Jetblack31/EcoPV/schematics/schematics.md

This directory contains schematics of EcoPV circuits.
