Jetblack31/EcoPV/devices/PCB_V1.png

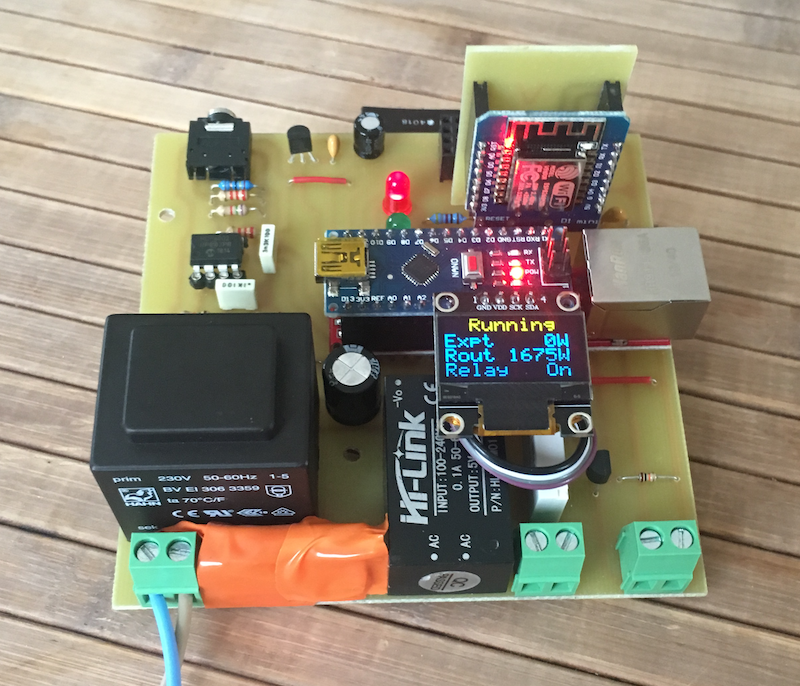
devices/PCB_V1.png
