Jetblack31/EcoPV/devices/ShieldEthernet.png

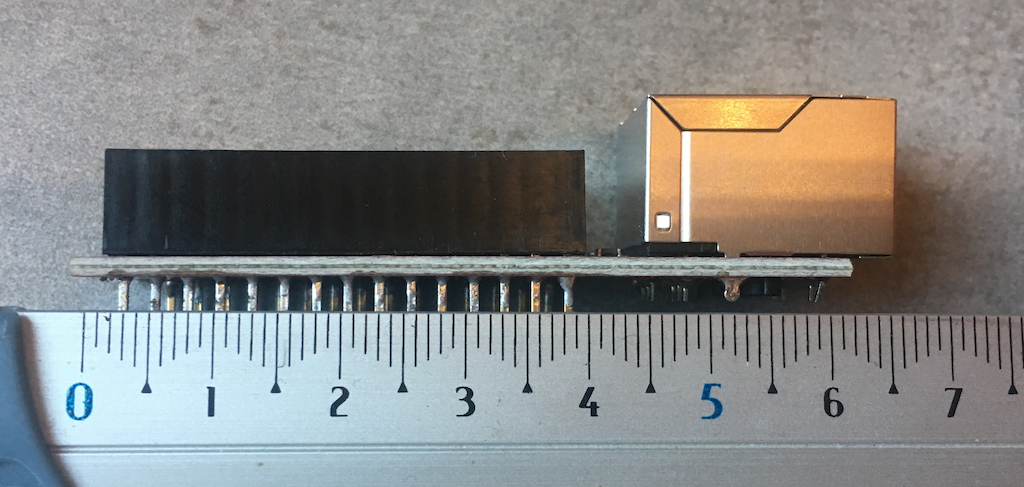
devices/ShieldEthernet.png
