Jetblack31/EcoPV/screenshots/MenuConfiguration.png

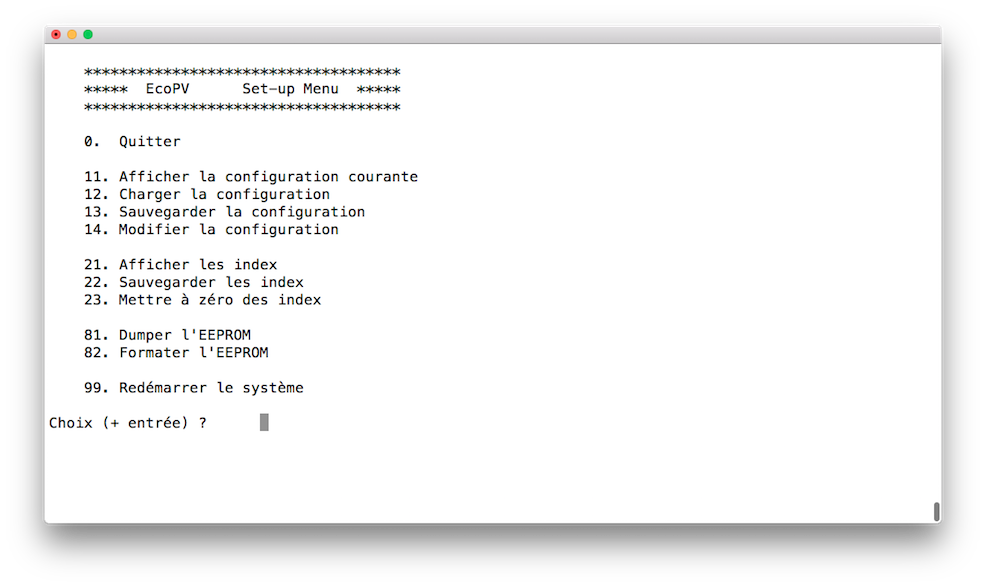
screenshots/MenuConfiguration.png
