Jetblack31/EcoPV/screenshots/openHAB.png

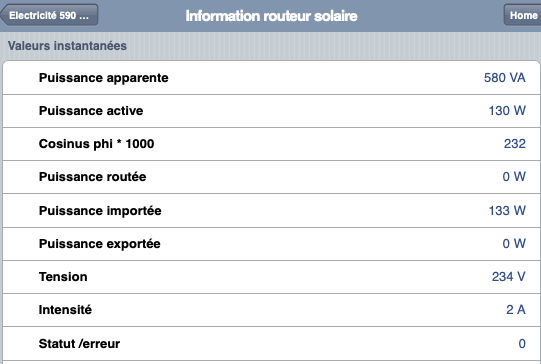
screenshots/openHAB.png
