Jetblack31/EcoPV/screenshots/Paramètres.png

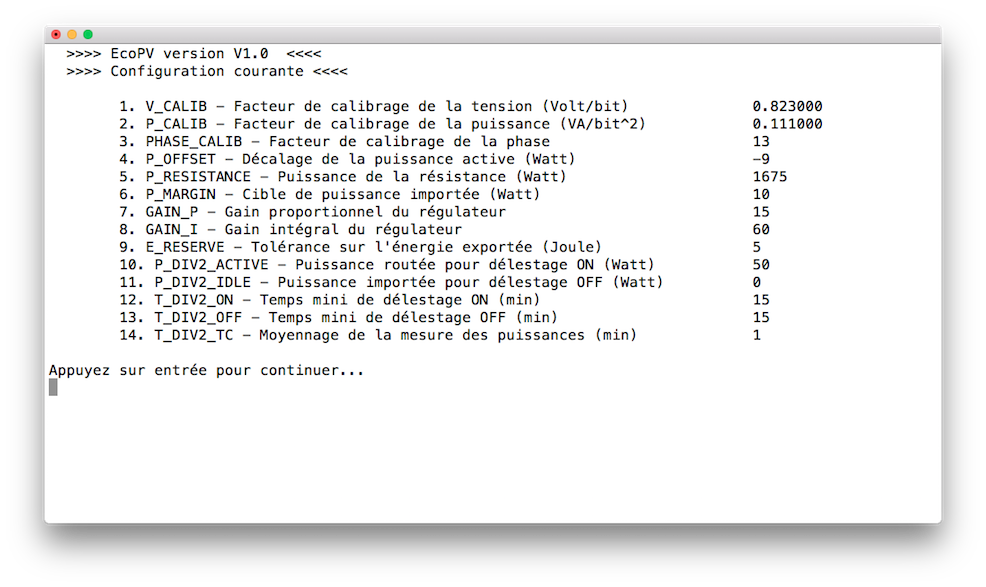
screenshots/Paramètres.png
