Jetblack31/EcoPV/screenshots/test_new.png

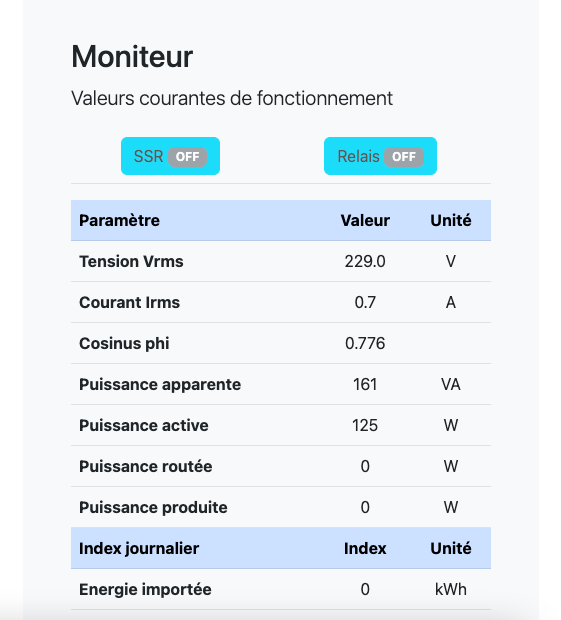
screenshots/test_new.png
