Jetblack31/EcoPV/(threads)

Thread 2 (2019-10-01):

Sonde supplémentaire

Grubuntu, 2019-10-01:
Une sonde supplémentaire pour pouvoir suivre aussi la production solaire, ça permettrait de centraliser le suivi de production, consommation et routage sur un seul arduino.

Jetblack31, 2019-10-01:
Une entrée pour impulsions d'un compteur de production est prévue pour bientôt.
Par contre ce n'est pas possible d'ajouter une pince ampéremétrique, ça ralentirait l'arduino...

Closed 2019-10-01.

Thread 3 (2020-01-13):

Petite faute dans le readme

FredM67, 2020-01-13:
peuvent dépendrent =>peuvent dépendre

Jetblack31, 2020-01-13:
Je corrige, merci beaucoup !

FredM67, 2020-01-13:
De rien...au fait si je peux aider pour l'EcoPV tri... Je suis dispo 😁

Bonne fin de journée
Fred

Télécharger Outlook pour Android<https://aka.ms/ghei36>

________________________________
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

FredM67, 2020-01-17:
Salut,

Pour info, j'ai mis à jour le sketch pour le routeur tri de Robin.
J'ai rajouté pas mal de truc, et j'ai essayé de faire une doc à peu prêt correcte.

Fred

Envoyé à partir d’Outlook<http://aka.ms/weboutlook>

________________________________
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

Jetblack31, 2020-01-19:
Salut,
je ne suis pas sûr de comprendre, tu as fait un sketch pour du tri sur la base de EcoPV ?

A+
Jetblack

FredM67, 2020-01-19:
Hello,
Non, j'ai réécrit le sketch du routeur tri de Robin en rajoutant des fonctionnalités genre capteur de température,...
Peut-être ça pourra aider pour ton EcoPV tri...
Fred

Télécharger Outlook pour Android<https://aka.ms/ghei36>

________________________________
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

Thread 4 (2020-01-24):

Programme qui se fige

Shonoxy, 2020-01-24:
Salut,

Avant tout un grand merci pour ton travail !

Je rencontre un petit souci et je pense en être la cause mais je ne vois pas d'où ça vient :)

J'ai monter le projet entièrement grâce au PCB format DIN fournis sur le forum forum-photovoltaique.fr. J'ai ajouté l'écran et j'ai aussi un wemos du coup.

Mon problème est que lorsque je branche le 230v sur mon PCB au bout de quelques secondes (ça varie entre 3 et 20 sec environ) le programme se fige. Les LED se fige, l'écran aussi et le moniteur série (celui de l'application arduino) aussi.

J'ai fait le test de brancher l'arduino en usb uniquement et dans ce cas le programme tourne correctement et ne se fige jamais. Mais dés que je branche le 230v tout se fige à nouveau.

J'ai lu dans ta documentation que : "en absence du circuit analogique fonctionnel, le programme ne détectera pas la synchronisation secteur et entrera dans un mode d'erreur."
Ayant fait la plupart de mes tests en ayant ni la pince ni le SSR de brancher mon problème pourrait-il venir de ça ? J'ai essayé tout de même de brancher la pince mais ça na rien changé. Elle pourrait être défectueuse peut être.

Voila le dernier état avant crash que j'ai :

`18:12:15.508 ->
***      Statistiques      ***
18:12:15.508 ->
18:12:15.508 -> Up time   : 0 jours 0 h 1 min 49 s
18:12:15.508 -> Vrms   : 274.1 V
18:12:15.508 -> Irms   : 0.112 A
18:12:15.508 -> Cos phi   : -0.523
18:12:15.508 -> Sin phi   : 0.852
18:12:15.508 -> Pappar   : 31 VA
18:12:15.508 -> Pactive   : -16.0 W - Valeur filtrée : -5 W  (export)
18:12:15.508 -> Proutée   : 1500 W - Valeur filtrée : 1244 W
18:12:15.508 -> Index 1   : nan kWh routés
18:12:15.508 -> Index 2   : nan kWh exportés
18:12:15.508 -> Index 3   : nan kWh importés
18:12:15.508 -> Index 4   : -1 impulsions
18:12:15.508 -> Vbias   : 2.309 V
18:12:15.508 -> Nb éch.   : 8321
18:12:15.543 -> SSR Dly   : 0.51 / 0.51 / 0.51 (min / avg / max [ms])
18:12:15.543 -> Status   : 111
18:12:15.543 -> Relais ON
`

Je suis étonné par les 1500W routée alors que rien n'est branché dessus mais c'est peut être normal.

Aurais-tu une idée de ce qui pourrait coincer ? Mes soudures bonnes. Je pense tester avec un autre arduino demain et éventuellement tester tous mes composants.

Merci d'avance pour ton aide 👍

Jetblack31, 2020-01-25:
Bonjour,

Une première chose, l'absence de circuit analogique ou de signal valide ne figera pas le fonctionnement. Au pire, le système passe en état d'erreur fatale, mais dans ce cas, les leds clignotent rapidement et le système essaie de re-démarrer.

Le seul cas rencontré qui conduit à un freeze total est lié à un dysfonctionnement de l'écran Oled. En effet, si pour une raison ou une autre l'écran pose problème, alors tout le programme se fige... Ce n'est pas optimal, mais je n'ai pas trouvé de solution pour éviter cela. Une personne du forum a reçu un écran Oled problématique qui provoquait ce type de symptôme.

Dans un premier temps, pourrais-tu faire le test suivant :
- écran Oled débranché
- programme compilé sans l'option écran Oled
- test du système sur 230V.

Fais moi un retour et on avisera si le problème persiste.

Jetblack

Shonoxy, 2020-01-25:
C'était bien l'écran :)
J'ai suivi tes instructions et tout roule ! Merci !

Thread 5 (2020-03-11):

Problème Ordre Calibration P_OFFSET et P_CALIB

seby90, 2020-03-11:
Salut Jetblack,

Comme tu l'as indiqué la définition de PHASE_CAL est très importante pour la qualité de la régulation et de l'injection.

Dans mon cas précis et selon nos échanges passés, j'ai été obligé de laisser P_OFFSET à 0 pour trouver la bonne valeur de PHASE_CAL (proche de 13) puis seulement une fois PHASE CAL défini alors je renseigne P_OFFSET qui chez moi est à -11. Si je renseigne P_OFFSET en 1er , j'ai un tel écart en Pappar et Pactive que j'en arrive à un PHASE_CAL entre 30 et 40 (et une lecture Pactive pas cohérente avec mon wattmètre tête de ligne.

Suivant ta notice de calibration dispo sur ton github, il faut d'abord définir P_OFFSET et seulement après PHASE_CAL . P_OFFSET agissant directement sur la lecture de la puissance active et le Cos/Sin Phi étant calculé sur le ratio de Pappar et Pactive, de ce fait ça change tout pour la définition de PHASE_CAL

Quand est il sur le sujet ? Dans la procédure de calibration qui doit être précise, doit on calibrer PHASE_CAL avec P_OFFSET à 0, puis seulement  une fois PHASE_CAL défini on renseigne P_OFFSET ?? En sachant qu'en pratiquant cette méthode, l'affichage du Cos Phi d'EcoPV ne devient plus cohérente avec l'installation ...

Phillema, 2020-03-29:
Salut Seby90et jetblack,  je suis dans un cas similaire :  j'ai installé ton EcoPV qui tourne bien,  mais je n'ai pas encore finalisé tous les ajustements : P_Calib, Phase_Calib,  etc ...  donc la réponse à la question de Seb90 sur l'ordre des réglages m'interresse beaucoup  Et encore merci JetBlack d'avoir peaufiné ton code 👍

Thread 6 (2020-04-16):

Features MQTT with Ethernet W5100 / W5500

robotsflo, 2020-04-16:
**Pour commencer, je dois vous féliciter pour cet énorme travail réalisé avec un code commenté / documenté et très explicite.**

Je pense que le projet "EcoPV" pourrait s'agrémenter d'une compatibilité avec les puces ethernet  W5100 et  W5500. A la lecture du code cela me semble assez simple à implémenter étant donné qu'il s'agit d'une bibliothèque Arduino (Ethernet.h).
Une fonctionnalité supplémentaire serait aussi très intéressante car universelle dans le monde de l'IoT : le MQTT, en effet l'API HTTP c'est parfait pour la consultation.
En revanche, l'utilisation d'un serveur domotique oblige d'interroger le serveur HTTP de manière périodique. A contrario, le protocole MQTT, largement supporté par les solutions domotiques (HomeAssistant, Openhab, Domoticz, Jeedom ...), se démarque du protocole HTTP par sa rapidité du transfert de l'information ce qui permet à des scénarios domotiques d'être très réactifs.
Encore un énorme bravo, et n'hésitez pas à communiquer un lien de Don Paypal pour ceux qui le souhaitent.

Jetblack31, 2020-04-25:
Bonjour,

Merci beaucoup pour le message de soutien, ca me fait plaisir.
Concernant le support ethernet, la limitation vient de la mémoire programme et surtout de la mémoire data, il n'y en a pas beaucoup dans l'arduino et je suis aux limites... J'ai dû choisir une bibliothèque très légère pour supporter le TCP avec la puce du shield proposé. Toutes les autres bibliothèques étaient trop gourmandes en mémoire. MQTT serait en effet plus efficace, je n'ai pas d'expérience sur ce protocole. Je vais essayer de me renseigner.
S'il y a évolution, ca se fera sur la base du Nano Every, qui a le même brochage mais plus de puissance et de mémoire. Toutefois, le portage demande un peu de travail et je coince actuellement pour configurer un taux d'acquisition ADC personnalisé... A creuser...

J'ai ajouté un bouton "Sponsor" dans la barre des actions du GitHub, ca permet de faire des dons via PayPal !

A+
Jetblack

robotsflo, 2020-04-27:
Je comprend désormais mieux les difficultés rencontrées à supporter des shields ETH différents et des fonctionnalités supplémentaires. Je pense que ton programme fonctionnerait sur ATMega 2560 avec le support de nouvelles cartes ETH et de fonctionnalités supplémentaires tel que le MQTT par exemple. Néanmoins cette puce ne respecte plus du tout le brochage du nano et est un peu plus couteuse à l'achat. Etant donné que je dispose d'une puce similaire ainsi que d'un shield ethernet w5500 en rab, il faudrait que je me penche sur la réécriture de ton code, mais je crains que ce soit trop complexe pour moi étant donné que tu écris directement dans les registres pour optimiser les temps machine. La réalisation ensuite d'une carte PCB d'adaptation au brochage du nano pourrait être envisageable.
La deuxième solution plus simple serait de m'inspirer du fonctionnement d'un ESP12 sur SerialBridge.ino et de l'adapter à un deuxième arduino nano connecté en Série au premier, ainsi qu'à une carte shield ethernet. (je ne suis pas fan du wifi pour ces applications fonctionnant constamment, rien de tel qu'un bon vieux câble ethernet). Je te ferais un retour de l'avancée de mes recherches, pour l'instant je dois déjà raccorder l'ancienne version du router PV de Tigrous à base de compteur DIN.

Au plaisir d'échanger d'avantage sur le sujet.
A+

Thread 8 (2020-05-08):

Comptage "Index Routé" actif, même avec de l'export...

airwaner, 2020-05-08:
Bonjour,
Tout d'abord, je tenais à vous féliciter pour tout le travail déjà accompli, c'est vraiment un projet très abouti!

Je me permets toutefois d'ajouter ma petite contribution, car j'ai remarqué un comportement qui n'est pas forcément normal. En effet, comme vous pourrez le constater sur cette capture ,

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

ils s'avère qu'à l'instant où elle à été prise, j'étais en train d'exporter de l'énergie.

Comme on peut le voir, j'exporte 1048W et le routeur qui fait correctement son travail tente d'injecter ce surplus vers le ballon (stéatite, délestée de 2 de ses 3 circuits).
Malheureusement, le ballon est déjà arrivé à sa température maximale, et donc le thermostat a naturellement séparé la résistance du routeur.

Je constate néanmoins que "l'index routé" continue de s'incrémenter, même si le ballon ne prend plus d'énergie.
Ma question est:
- Même si je me doute bien qu'il n'y a pas de retour réel d'information quant à l'énergie effectivement consommée par le ballon, il devrait en théorie être possible d'inhiber l'incrémentation du compteur, au moins le temps d'une injection vers Enedis?

Je ne vois pas quelle serait la charge de travail, ni même si cela sera utile d'y remédier, mais il m'à semblé important de remonter ce comportement, au cas où il n'aurait pas déjà été détecté.
Soit dit en passant, cette correction ne fiabilisera pas la donnée à 100% puisque même si les kWh pas vraiment routés mais en fait exportés ne sont finalement détectables qu'en cas d'export , il ne sera peut-être pas possible de détecter les kWh "routés" mais non utilisés si il n'y a pas d'export...

Thread 9 (2021-09-24):

Intégrer une énergie mini journalière importée dans le ballon

LaloucheJB, 2021-09-24:
Bonjour,

merci pour le gros travail déjà effectué !

Pour assurer de l'eau chaude, est ce qu'une fonction pourrai se déclencher à heure fixe, par exemple :
à 18h si 3kWh n'ont pas été injecté dans le ballon, "marche forcée" jusqu’à 3kWh ?  En pouvant paramétrer l'heure, la quantité d'énergie et la puissance de de la marche forcée.

Ça implique une horloge par contre.

Jetblack31, 2021-09-24:
Bonjour,

il y a une fonction scheduler dans EcoPV qui permet de déclencher des actions à des moments ou des intervalles de temps définis, toutefois il n'y a pas d'horloge intégrée qui contienne l'heure exacte. Sur le forum photovoltaïque, quelqu'un a ajouté cette fonction horloge à EcoPV, sur la base d'un module externe DCF77, me semble-t-il.
Sur le principe, ce que vous souhaitez faire est donc possible, pas très complexe au niveau du code, la difficulté à gérer c'est l'espace mémoire disponible pour le programme dans l'arduino. Toutefois, en enlevant quelques fonctions (écran ou communication) ce serait possible sans souci.

Chez moi, je réalise la fonction que vous souhaitez mais c'est le système de domotique (qui tourne sur un raspberry), qui monitore la température du chauffe-eau et qui commande le réchauffage électrique si celle-ci est trop basse en fin de nuit pour l'utilisation du matin. Comme j'ai d'abord développé le système domotique avant EcoPV, j'ai développé EcoPV pour qu'il réalise une fonction de routage tout en étant communicant. Dans cet esprit, les fonctions complémentaires de plus haut niveau (délestage, complément de chauffe etc...) sont gérées par le système de domotique.

LaloucheJB, 2021-09-25:
Je comprends la philosophie.

Je n'ai pas encore pris en main le code. ça va me prendre du temps, ce n'est pas ma formation de base et ça fait longtemps que je n'ai pas mis la tête dans du code ...

Je vais potasser ... Et je ferai un retour (très probablement dans longtemps ... ) une fois que j'aurai quelque chose d'intéressant à partager.

Encore merci pour ton retour.

Thread 10 (2023-07-25):

Correction du tableau des retards de déclenchement

florentbr, 2023-07-25:
J'ai relevé un décalage significatif des valeurs du tableau des retards de déclenchement par rapport aux valeurs théoriques de puissance (energyToDelay).

En orange, la courbe théorique qui est bien a 50% de retard pour 50% de puissance
En bleu, la courbe des retards vs puissance du programme (energyToDelay).

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

Tableau des valeurs théoriques pour un retard compris entre [ 0, 148 ] :

```csv
148, 138, 134, 131, 129, 127, 126, 124, 123, 122, 121, 120, 119, 118, 117, 117,
116, 115, 115, 114, 113, 113, 112, 111, 111, 110, 110, 109, 109, 108, 108, 107,
107, 106, 106, 105, 105, 104, 104, 103, 103, 102, 102, 102, 101, 101, 100, 100,
100, 099, 099, 098, 098, 098, 097, 097, 097, 096, 096, 095, 095, 095, 094, 094,
094, 093, 093, 093, 092, 092, 092, 091, 091, 091, 090, 090, 090, 089, 089, 089,
088, 088, 088, 087, 087, 087, 086, 086, 086, 086, 085, 085, 085, 084, 084, 084,
083, 083, 083, 082, 082, 082, 082, 081, 081, 081, 080, 080, 080, 080, 079, 079,
079, 078, 078, 078, 077, 077, 077, 077, 076, 076, 076, 075, 075, 075, 075, 074,
074, 074, 073, 073, 073, 073, 072, 072, 072, 071, 071, 071, 071, 070, 070, 070,
069, 069, 069, 068, 068, 068, 068, 067, 067, 067, 066, 066, 066, 065, 065, 065,
065, 064, 064, 064, 063, 063, 063, 062, 062, 062, 062, 061, 061, 061, 060, 060,
060, 059, 059, 059, 058, 058, 058, 057, 057, 057, 056, 056, 056, 055, 055, 055,
054, 054, 054, 053, 053, 053, 052, 052, 051, 051, 051, 050, 050, 050, 049, 049,
048, 048, 048, 047, 047, 046, 046, 046, 045, 045, 044, 044, 043, 043, 042, 042,
041, 041, 040, 040, 039, 039, 038, 038, 037, 037, 036, 035, 035, 034, 033, 033,
032, 031, 030, 030, 029, 028, 027, 026, 025, 024, 022, 021, 019, 017, 014, 010,
```

La formule de calcule de la puissance en fonction du retard :

``` python
power_ratio = sin(phase_radian * 2)/2/pi - phase_radian/pi + 1
```
