Jetblack31/EcoPV/schematics/EcoPV_arduinoNano.pdf

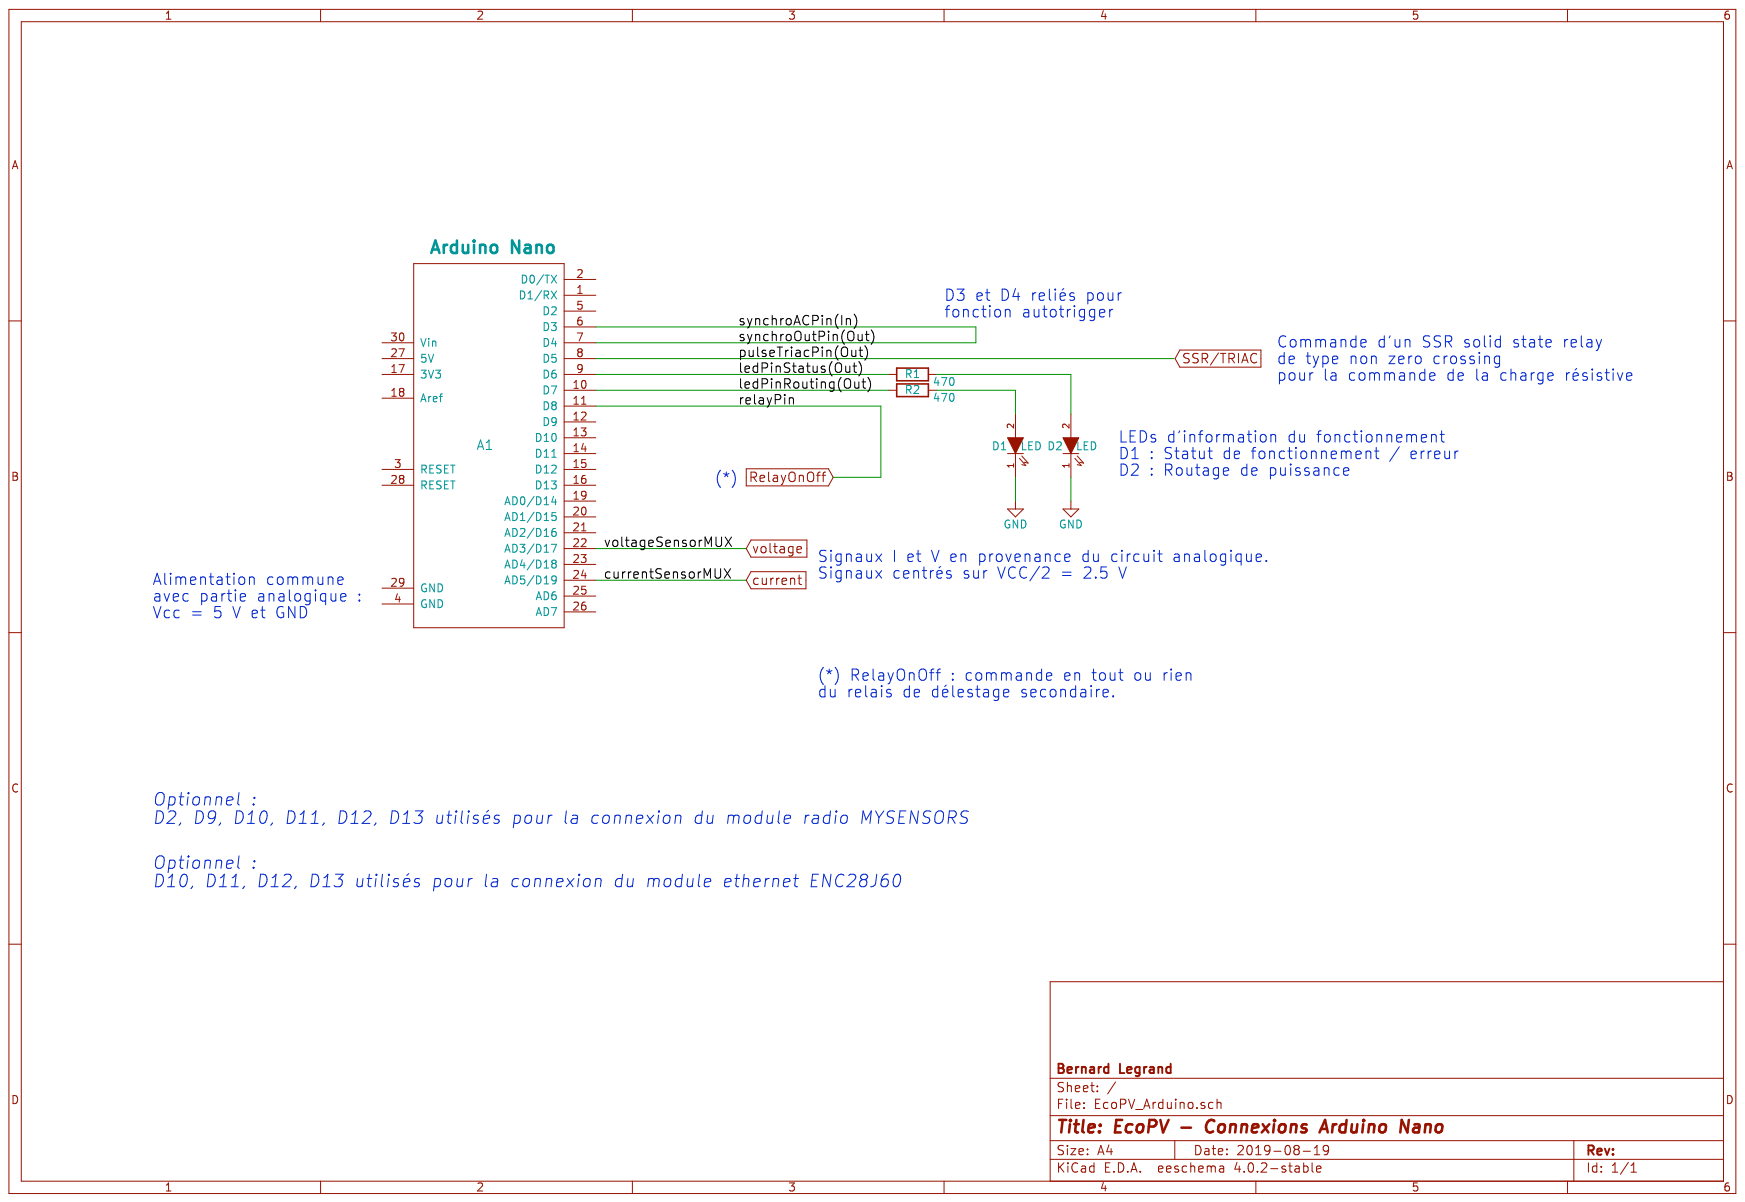
[picture p19: page 1]
