Jetblack31/EcoPV/schematics/EcoPV_analog.pdf

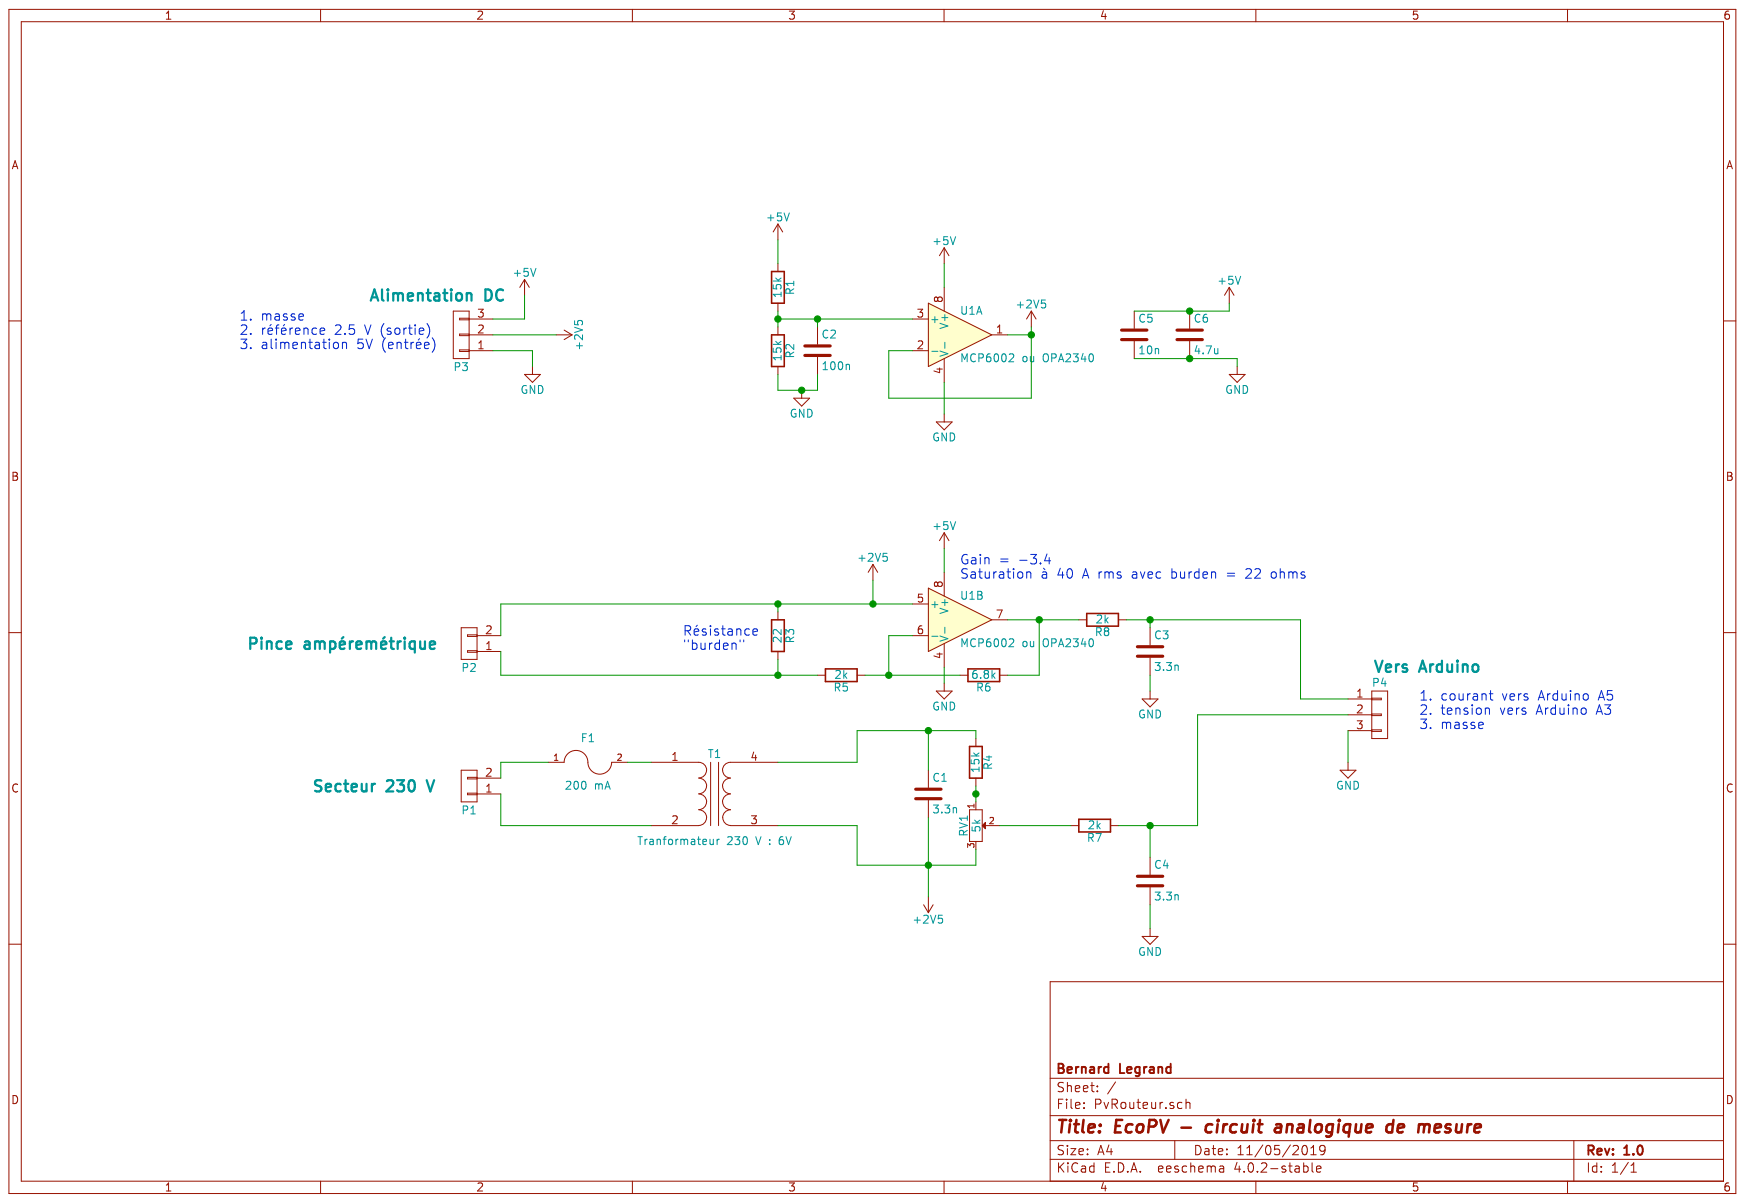
[picture p20: page 1]
