Jetblack31/EcoPV/(commit log)

2019-08-18 Update EcoPV.ino
    Mise à jour des messages d'affichage
2019-08-19 Modification de loop ()
    Suppression de l'affichage du temps de boucle dans les statistiques.
2019-08-22 Update EcoPV.ino
    modification de l'afficahe des statistiques
2019-08-22 Changements mineurs des commentaires du code
2019-08-22 Correction mineures de forme
    [EcoPV.ino]
2019-09-28 mise à jour de la doc
2019-09-28 MAJ des valeurs par défaut de la configuration
2019-09-29 Update EcoPV (Warning)
    Cast the pointer types to avoid warnings during compilation
    [EcoPV.ino]
2019-10-06 Modification de la procédure de calibrage
2019-10-14 correction de etherShield.cpp
2019-10-27 Possibilité de modifier les index
2019-10-28 Correction variables du compteur d'impulsion (1)
    [EcoPV.ino]
2019-11-16 Update EcoPV.ino
    Mise au propre du code pour la gestion de l'index de comptage des impulsions et ajout de la lecture de l'index par l'API
2019-11-16 Correction librairies
    Correction des librairies du shield Ethernet pour comptage d'impulsion sur D2
2020-04-26 Ajout traceur serie arduino ide (#7)
    * Create test.md
    * Delete test.md
    * update 1
    screenshot et detail utilisation
    * Update mise en page fichier explications
    * Mod Graphe Arduino IDE
    Ajout fonction affichage graphique courbes avec arduino IDE
    * Update Ajout-Traceur-serie-Arduino-IDE.md
    Ajout d'un espace dans le texte
    * Update EcoPV.ino
    Quelques mises en forme du code
    * maj variables volatiles dans la loop
    * Update Ajout-Traceur-serie-Arduino-IDE.md
    * maj variables volatiles
    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
2020-04-26 Correction mineure du MOD STF
    [EcoPV.ino]
2020-05-01 Correction V1.2
    Gain de memoire
    [EcoPV.ino, SerialBridge.ino, SerialBridgePortal.ino]
